sarahemm/stackclock/README.md

# stackclock
StackClock - Modular configurable high-accuracy desk clock
