sarahemm/stackclock/arduino-bsp/README.md

This directory contains the files needed to add board support for the StackClock boards to the Arduino IDE.
