sarahemm/stackclock/display/hardware/stackclock_display.brd

## EAGLE design display/hardware/stackclock_display.brd (2018-03-08)

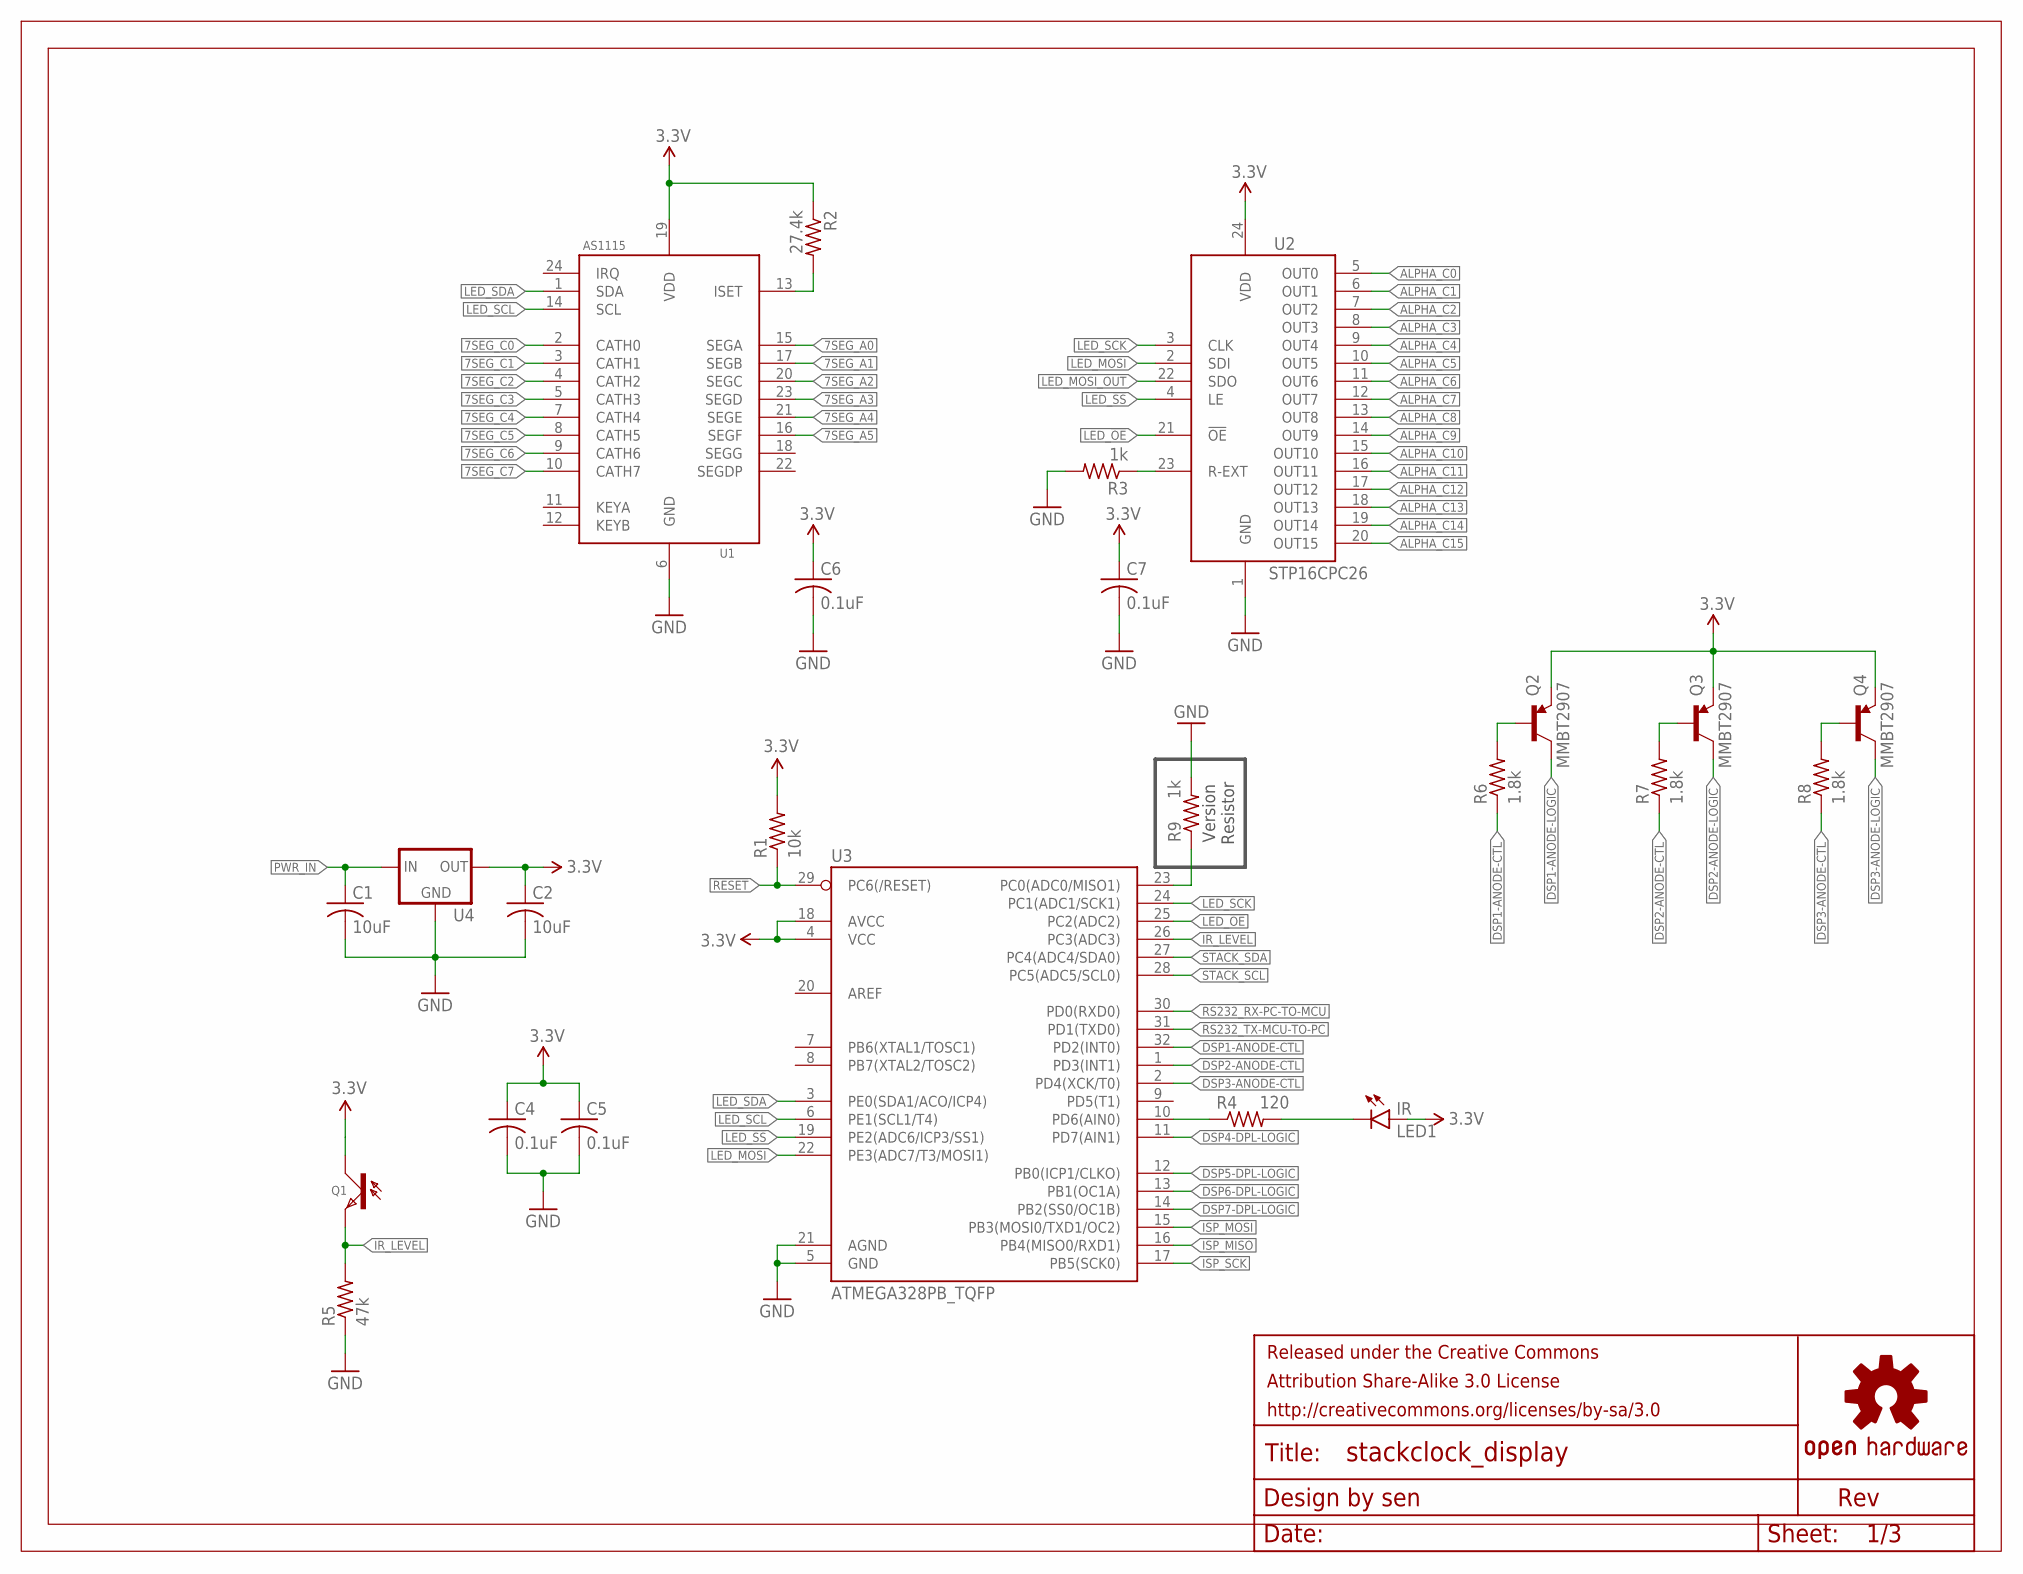
[picture p1: schematic stackclock_display.sch, sheet 1, Logic]

Parts:
C1, C2: 10uF; C0805
C4, C5, C6, C7: 0.1uF; C0603
FRAME1: FRAME-LETTER-GRID-OSHW-SENOSHW-LOGO-L; OSHW-LOGO-L
LED1: IR; LED-1206
Q1: PT15-21C/TR8; 1206_PHOTOTRANSISTOR
Q2, Q3, Q4: MMBT2907; SOT23-3
R1: 10k; R0603
R2: 27.4k; R0603
R3, R9: 1k; R0603
R4: 120; R0603
R5: 47k; R0603
R6, R7, R8: 1.8k; R0603
U1: AS1115; QSOP24
U2: STP16CPC26; TSSOP24
U3: ATMEGA328PB_TQFP; TQFP32-08
U4: NCP1117DT33G; DPAK

Connections:
3.3V: C2.1, C4.1, C5.1, C6.1, C7.1, LED1.A, Q1.C, Q2.2 (E), Q3.2 (E), Q4.2 (E), R1.2, R2.1, U1.19 (VDD), U2.24 (VDD), U3.4 (VCC), U3.18 (AVCC), U4.4 (OUT); also elsewhere on the board
7SEG_A0: U1.15 (SEGA); also elsewhere on the board
7SEG_A1: U1.17 (SEGB); also elsewhere on the board
7SEG_A2: U1.20 (SEGC); also elsewhere on the board
7SEG_A3: U1.23 (SEGD); also elsewhere on the board
7SEG_A4: U1.21 (SEGE); also elsewhere on the board
7SEG_A5: U1.16 (SEGF); also elsewhere on the board
7SEG_C0: U1.2 (CATH0); also elsewhere on the board
7SEG_C1: U1.3 (CATH1); also elsewhere on the board
7SEG_C2: U1.4 (CATH2); also elsewhere on the board
7SEG_C3: U1.5 (CATH3); also elsewhere on the board
7SEG_C4: U1.7 (CATH4); also elsewhere on the board
7SEG_C5: U1.8 (CATH5); also elsewhere on the board
7SEG_C6: U1.9 (CATH6); also elsewhere on the board
7SEG_C7: U1.10 (CATH7); also elsewhere on the board
!RESET: R1.1, U3.29 (PC6(/RESET)); also elsewhere on the board
ALPHA_C0: U2.5 (OUT0); also elsewhere on the board
ALPHA_C1: U2.6 (OUT1); also elsewhere on the board
ALPHA_C2: U2.7 (OUT2); also elsewhere on the board
ALPHA_C3: U2.8 (OUT3); also elsewhere on the board
ALPHA_C4: U2.9 (OUT4); also elsewhere on the board
ALPHA_C5: U2.10 (OUT5); also elsewhere on the board
ALPHA_C6: U2.11 (OUT6); also elsewhere on the board
ALPHA_C7: U2.12 (OUT7); also elsewhere on the board
ALPHA_C8: U2.13 (OUT8); also elsewhere on the board
ALPHA_C9: U2.14 (OUT9); also elsewhere on the board
ALPHA_C10: U2.15 (OUT10); also elsewhere on the board
ALPHA_C11: U2.16 (OUT11); also elsewhere on the board
ALPHA_C12: U2.17 (OUT12); also elsewhere on the board
ALPHA_C13: U2.18 (OUT13); also elsewhere on the board
ALPHA_C14: U2.19 (OUT14); also elsewhere on the board
ALPHA_C15: U2.20 (OUT15); also elsewhere on the board
DSP1-ANODE-CTL: R6.1, U3.32 (PD2(INT0))
DSP1-ANODE-LOGIC: Q2.3 (C); also elsewhere on the board
DSP1-ANODE-QR: Q2.1 (B), R6.2
DSP2-ANODE-CTL: R7.1, U3.1 (PD3(INT1))
DSP2-ANODE-LOGIC: Q3.3 (C); also elsewhere on the board
DSP2-ANODE-QR: Q3.1 (B), R7.2
DSP3-ANODE-CTL: R8.1, U3.2 (PD4(XCK/T0))
DSP3-ANODE-LOGIC: Q4.3 (C); also elsewhere on the board
DSP3-ANODE-QR: Q4.1 (B), R8.2
DSP4-DPL-LOGIC: U3.11 (PD7(AIN1)); also elsewhere on the board
DSP5-DPL-LOGIC: U3.12 (PB0(ICP1/CLKO)); also elsewhere on the board
DSP6-DPL-LOGIC: U3.13 (PB1(OC1A)); also elsewhere on the board
DSP7-DPL-LOGIC: U3.14 (PB2(SS0/OC1B)); also elsewhere on the board
GND: C1.2, C2.2, C4.2, C5.2, C6.2, C7.2, R3.2, R5.1, R9.2, U1.6 (GND), U2.1 (GND), U3.5 (GND), U3.21 (AGND), U4.1 (GND); also elsewhere on the board
HW_VERSION: R9.1, U3.23 (PC0(ADC0/MISO1))
IR_CTL: R4.1, U3.10 (PD6(AIN0))
IR_LEVEL: Q1.E, R5.2, U3.26 (PC3(ADC3)); also elsewhere on the board
IR_R: LED1.C, R4.2
ISP_MISO: U3.16 (PB4(MISO0/RXD1)); also elsewhere on the board
ISP_MOSI: U3.15 (PB3(MOSI0/TXD1/OC2)); also elsewhere on the board
ISP_SCK: U3.17 (PB5(SCK0)); also elsewhere on the board
LED_!OE: U2.21 (!OE), U3.25 (PC2(ADC2)); also elsewhere on the board
LED_!SS: U2.4 (LE), U3.19 (PE2(ADC6/ICP3/SS1)); also elsewhere on the board
LED_MOSI: U2.2 (SDI), U3.22 (PE3(ADC7/T3/MOSI1)); also elsewhere on the board
LED_MOSI_OUT: U2.22 (SDO); also elsewhere on the board
LED_SCK: U2.3 (CLK), U3.24 (PC1(ADC1/SCK1)); also elsewhere on the board
LED_SCL: U1.14 (SCL), U3.6 (PE1(SCL1/T4)); also elsewhere on the board
LED_SDA: U1.1 (SDA), U3.3 (PE0(SDA1/ACO/ICP4)); also elsewhere on the board
PWR_IN: C1.1, U4.3 (IN); also elsewhere on the board
RS232_RX-PC-TO-MCU: U3.30 (PD0(RXD0)); also elsewhere on the board
RS232_TX-MCU-TO-PC: U3.31 (PD1(TXD0)); also elsewhere on the board
STACK_SCL: U3.28 (PC5(ADC5/SCL0)); also elsewhere on the board
STACK_SDA: U3.27 (PC4(ADC4/SDA0)); also elsewhere on the board
U1-ISET: R2.2, U1.13 (ISET)
U2-REXT: R3.1, U2.23 (R-EXT)

Notes on the sheet:
Version Resistor

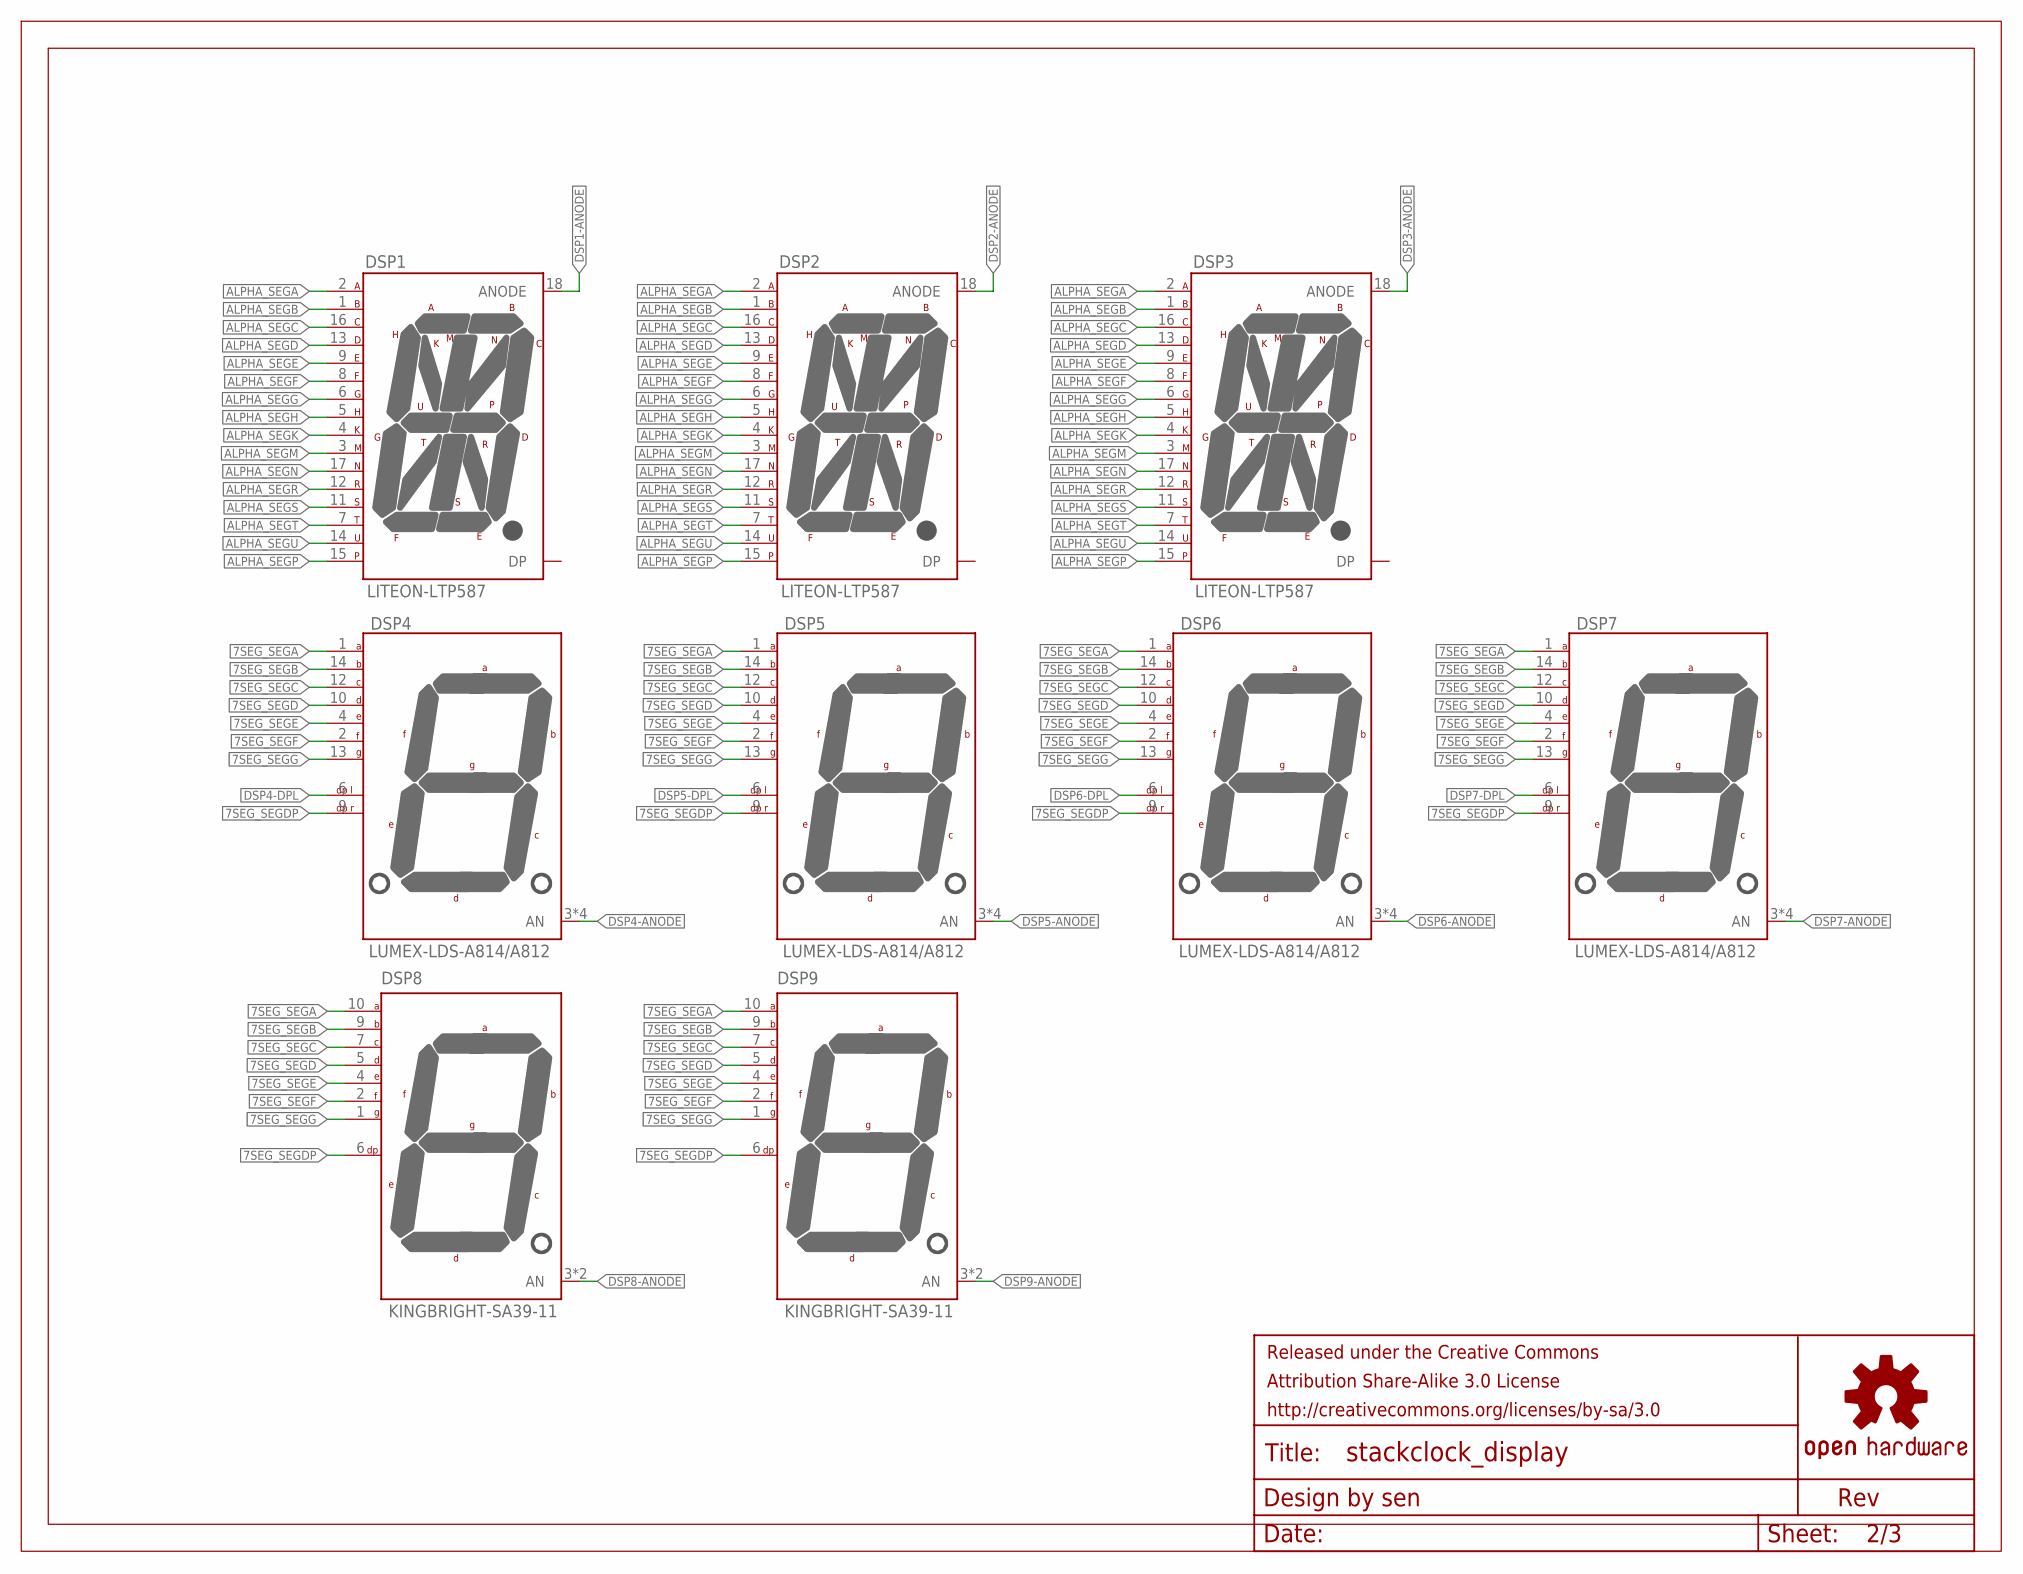
[picture p2: schematic stackclock_display.sch, sheet 2, Display]

Parts:
DSP1, DSP2, DSP3: LITEON-LTP587
DSP4, DSP5, DSP6, DSP7: LUMEX-LDS-A814/A812
DSP8, DSP9: KINGBRIGHT-SA39-11
FRAME2: FRAME-LETTER-GRID-OSHW-SENOSHW-LOGO-L; OSHW-LOGO-L

Connections:
7SEG_SEGA: DSP4.1 (A), DSP5.1 (A), DSP6.1 (A), DSP7.1 (A), DSP8.10 (A), DSP9.10 (A); also elsewhere on the board
7SEG_SEGB: DSP4.14 (B), DSP5.14 (B), DSP6.14 (B), DSP7.14 (B), DSP8.9 (B), DSP9.9 (B); also elsewhere on the board
7SEG_SEGC: DSP4.12 (C), DSP5.12 (C), DSP6.12 (C), DSP7.12 (C), DSP8.7 (C), DSP9.7 (C); also elsewhere on the board
7SEG_SEGD: DSP4.10 (D), DSP5.10 (D), DSP6.10 (D), DSP7.10 (D), DSP8.5 (D), DSP9.5 (D); also elsewhere on the board
7SEG_SEGDP: DSP4.9 (DP-R), DSP5.9 (DP-R), DSP6.9 (DP-R), DSP7.9 (DP-R), DSP8.6 (DP), DSP9.6 (DP); also elsewhere on the board
7SEG_SEGE: DSP4.4 (E), DSP5.4 (E), DSP6.4 (E), DSP7.4 (E), DSP8.4 (E), DSP9.4 (E); also elsewhere on the board
7SEG_SEGF: DSP4.2 (F), DSP5.2 (F), DSP6.2 (F), DSP7.2 (F), DSP8.2 (F), DSP9.2 (F); also elsewhere on the board
7SEG_SEGG: DSP4.13 (G), DSP5.13 (G), DSP6.13 (G), DSP7.13 (G), DSP8.1 (G), DSP9.1 (G); also elsewhere on the board
ALPHA_SEGA: DSP1.2 (A), DSP2.2 (A), DSP3.2 (A); also elsewhere on the board
ALPHA_SEGB: DSP1.1 (B), DSP2.1 (B), DSP3.1 (B); also elsewhere on the board
ALPHA_SEGC: DSP1.16 (C), DSP2.16 (C), DSP3.16 (C); also elsewhere on the board
ALPHA_SEGD: DSP1.13 (D), DSP2.13 (D), DSP3.13 (D); also elsewhere on the board
ALPHA_SEGE: DSP1.9 (E), DSP2.9 (E), DSP3.9 (E); also elsewhere on the board
ALPHA_SEGF: DSP1.8 (F), DSP2.8 (F), DSP3.8 (F); also elsewhere on the board
ALPHA_SEGG: DSP1.6 (G), DSP2.6 (G), DSP3.6 (G); also elsewhere on the board
ALPHA_SEGH: DSP1.5 (H), DSP2.5 (H), DSP3.5 (H); also elsewhere on the board
ALPHA_SEGK: DSP1.4 (K), DSP2.4 (K), DSP3.4 (K); also elsewhere on the board
ALPHA_SEGM: DSP1.3 (M), DSP2.3 (M), DSP3.3 (M); also elsewhere on the board
ALPHA_SEGN: DSP1.17 (N), DSP2.17 (N), DSP3.17 (N); also elsewhere on the board
ALPHA_SEGP: DSP1.15, DSP2.15, DSP3.15; also elsewhere on the board
ALPHA_SEGR: DSP1.12 (R), DSP2.12 (R), DSP3.12 (R); also elsewhere on the board
ALPHA_SEGS: DSP1.11 (S), DSP2.11 (S), DSP3.11 (S); also elsewhere on the board
ALPHA_SEGT: DSP1.7 (T), DSP2.7 (T), DSP3.7 (T); also elsewhere on the board
ALPHA_SEGU: DSP1.14 (U), DSP2.14 (U), DSP3.14 (U); also elsewhere on the board
DSP1-ANODE: DSP1.18 (ANODE); also elsewhere on the board
DSP2-ANODE: DSP2.18 (ANODE); also elsewhere on the board
DSP3-ANODE: DSP3.18 (ANODE); also elsewhere on the board
DSP4-ANODE: DSP4.3 (AN), DSP4.5 (AN), DSP4.11 (AN), DSP4.16 (AN); also elsewhere on the board
DSP4-DPL: DSP4.6 (DP-L); also elsewhere on the board
DSP5-ANODE: DSP5.3 (AN), DSP5.5 (AN), DSP5.11 (AN), DSP5.16 (AN); also elsewhere on the board
DSP5-DPL: DSP5.6 (DP-L); also elsewhere on the board
DSP6-ANODE: DSP6.3 (AN), DSP6.5 (AN), DSP6.11 (AN), DSP6.16 (AN); also elsewhere on the board
DSP6-DPL: DSP6.6 (DP-L); also elsewhere on the board
DSP7-ANODE: DSP7.3 (AN), DSP7.5 (AN), DSP7.11 (AN), DSP7.16 (AN); also elsewhere on the board
DSP7-DPL: DSP7.6 (DP-L); also elsewhere on the board
DSP8-ANODE: DSP8.3 (AN), DSP8.8 (AN); also elsewhere on the board
DSP9-ANODE: DSP9.3 (AN), DSP9.8 (AN); also elsewhere on the board

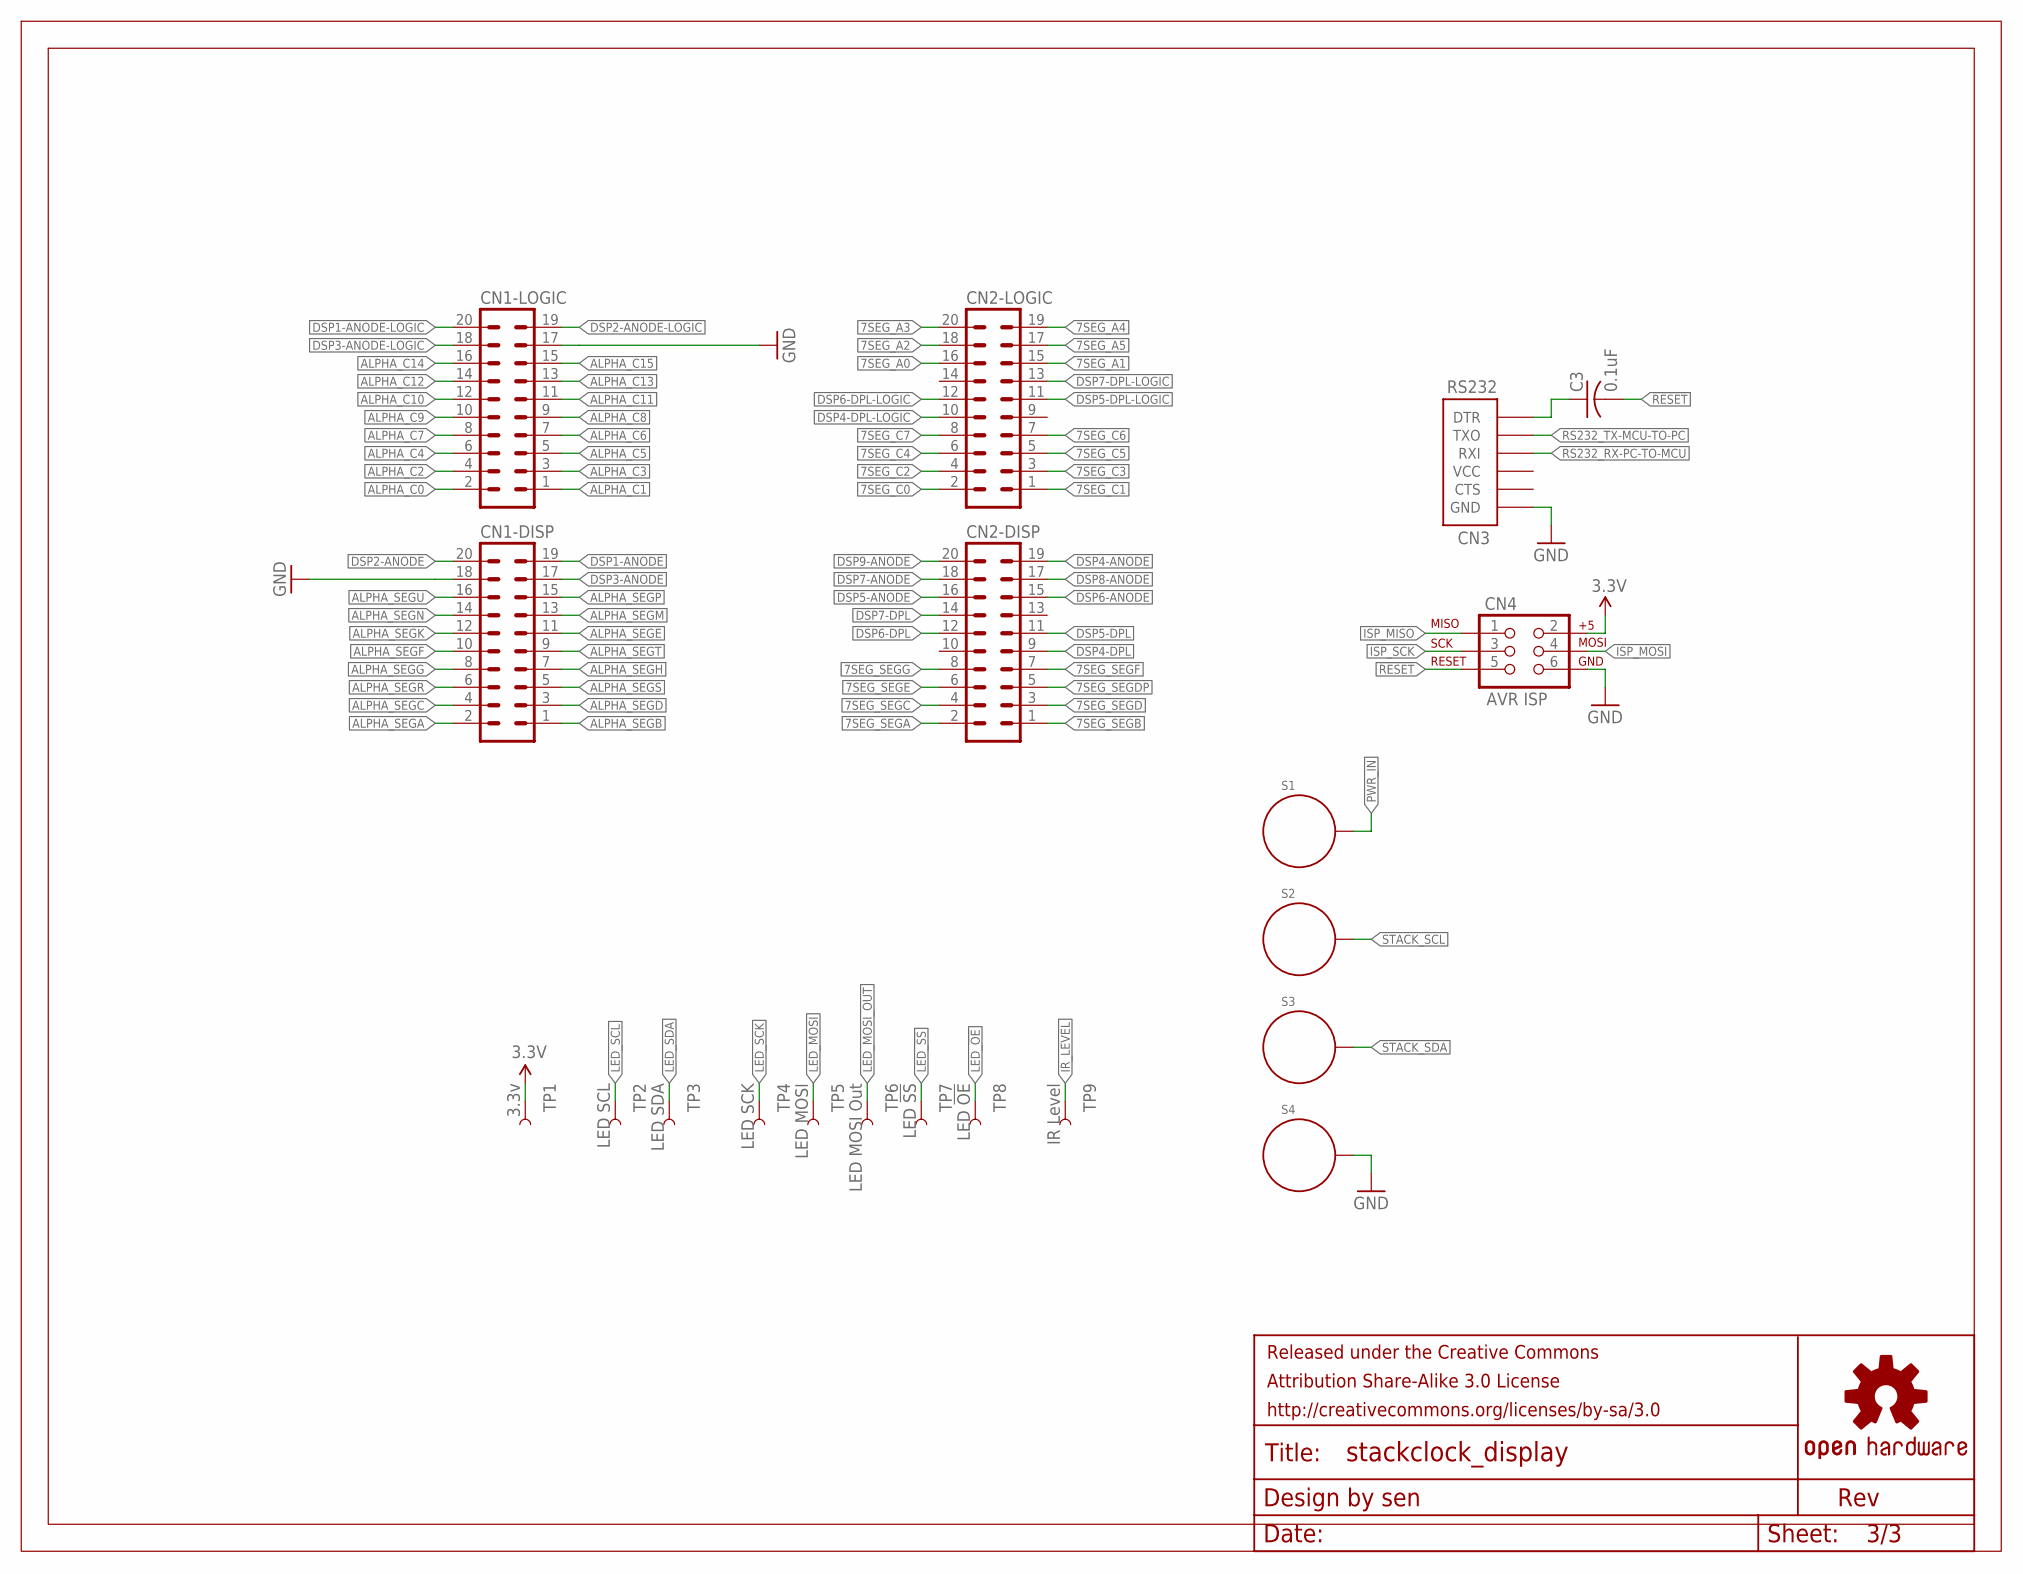
[picture p3: schematic stackclock_display.sch, sheet 3, I/O]

Parts:
C3: 0.1uF; C0603
CN1-DISP, CN2-DISP: MA10-2W
CN1-LOGIC, CN2-LOGIC: MA10-2
CN3: RS232; FTDI_DEVICE_SIDE
CN4: AVR ISP; 2X3_LOCK
FRAME3: FRAME-LETTER-GRID-OSHW-SENOSHW-LOGO-L; OSHW-LOGO-L
S1: +V; STANDOFF-ELECTRICAL
S2: SCL; STANDOFF-ELECTRICAL
S3: SDA; STANDOFF-ELECTRICAL
S4: GND; STANDOFF-ELECTRICAL
TP1: 3.3v; TP_15TH
TP2: LED SCL; TP_15TH
TP3: LED SDA; TP_15TH
TP4: LED SCK; TP_15TH
TP5: LED MOSI; TP_15TH
TP6: LED MOSI Out; TP_15TH
TP7: LED !SS; TP_15TH
TP8: LED !OE; TP_15TH
TP9: IR Level; TP_15TH

Connections:
3.3V: CN4.2, TP1.P$1; also elsewhere on the board
7SEG_A0: CN2-LOGIC.16; also elsewhere on the board
7SEG_A1: CN2-LOGIC.15; also elsewhere on the board
7SEG_A2: CN2-LOGIC.18; also elsewhere on the board
7SEG_A3: CN2-LOGIC.20; also elsewhere on the board
7SEG_A4: CN2-LOGIC.19; also elsewhere on the board
7SEG_A5: CN2-LOGIC.17; also elsewhere on the board
7SEG_C0: CN2-LOGIC.2; also elsewhere on the board
7SEG_C1: CN2-LOGIC.1; also elsewhere on the board
7SEG_C2: CN2-LOGIC.4; also elsewhere on the board
7SEG_C3: CN2-LOGIC.3; also elsewhere on the board
7SEG_C4: CN2-LOGIC.6; also elsewhere on the board
7SEG_C5: CN2-LOGIC.5; also elsewhere on the board
7SEG_C6: CN2-LOGIC.7; also elsewhere on the board
7SEG_C7: CN2-LOGIC.8; also elsewhere on the board
7SEG_SEGA: CN2-DISP.2; also elsewhere on the board
7SEG_SEGB: CN2-DISP.1; also elsewhere on the board
7SEG_SEGC: CN2-DISP.4; also elsewhere on the board
7SEG_SEGD: CN2-DISP.3; also elsewhere on the board
7SEG_SEGDP: CN2-DISP.5; also elsewhere on the board
7SEG_SEGE: CN2-DISP.6; also elsewhere on the board
7SEG_SEGF: CN2-DISP.7; also elsewhere on the board
7SEG_SEGG: CN2-DISP.8; also elsewhere on the board
!RESET: C3.2, CN4.5; also elsewhere on the board
ALPHA_C0: CN1-LOGIC.2; also elsewhere on the board
ALPHA_C1: CN1-LOGIC.1; also elsewhere on the board
ALPHA_C2: CN1-LOGIC.4; also elsewhere on the board
ALPHA_C3: CN1-LOGIC.3; also elsewhere on the board
ALPHA_C4: CN1-LOGIC.6; also elsewhere on the board
ALPHA_C5: CN1-LOGIC.5; also elsewhere on the board
ALPHA_C6: CN1-LOGIC.7; also elsewhere on the board
ALPHA_C7: CN1-LOGIC.8; also elsewhere on the board
ALPHA_C8: CN1-LOGIC.9; also elsewhere on the board
ALPHA_C9: CN1-LOGIC.10; also elsewhere on the board
ALPHA_C10: CN1-LOGIC.12; also elsewhere on the board
ALPHA_C11: CN1-LOGIC.11; also elsewhere on the board
ALPHA_C12: CN1-LOGIC.14; also elsewhere on the board
ALPHA_C13: CN1-LOGIC.13; also elsewhere on the board
ALPHA_C14: CN1-LOGIC.16; also elsewhere on the board
ALPHA_C15: CN1-LOGIC.15; also elsewhere on the board
ALPHA_SEGA: CN1-DISP.2; also elsewhere on the board
ALPHA_SEGB: CN1-DISP.1; also elsewhere on the board
ALPHA_SEGC: CN1-DISP.4; also elsewhere on the board
ALPHA_SEGD: CN1-DISP.3; also elsewhere on the board
ALPHA_SEGE: CN1-DISP.11; also elsewhere on the board
ALPHA_SEGF: CN1-DISP.10; also elsewhere on the board
ALPHA_SEGG: CN1-DISP.8; also elsewhere on the board
ALPHA_SEGH: CN1-DISP.7; also elsewhere on the board
ALPHA_SEGK: CN1-DISP.12; also elsewhere on the board
ALPHA_SEGM: CN1-DISP.13; also elsewhere on the board
ALPHA_SEGN: CN1-DISP.14; also elsewhere on the board
ALPHA_SEGP: CN1-DISP.15; also elsewhere on the board
ALPHA_SEGR: CN1-DISP.6; also elsewhere on the board
ALPHA_SEGS: CN1-DISP.5; also elsewhere on the board
ALPHA_SEGT: CN1-DISP.9; also elsewhere on the board
ALPHA_SEGU: CN1-DISP.16; also elsewhere on the board
DSP1-ANODE: CN1-DISP.19; also elsewhere on the board
DSP1-ANODE-LOGIC: CN1-LOGIC.20; also elsewhere on the board
DSP2-ANODE: CN1-DISP.20; also elsewhere on the board
DSP2-ANODE-LOGIC: CN1-LOGIC.19; also elsewhere on the board
DSP3-ANODE: CN1-DISP.17; also elsewhere on the board
DSP3-ANODE-LOGIC: CN1-LOGIC.18; also elsewhere on the board
DSP4-ANODE: CN2-DISP.19; also elsewhere on the board
DSP4-DPL: CN2-DISP.9; also elsewhere on the board
DSP4-DPL-LOGIC: CN2-LOGIC.10; also elsewhere on the board
DSP5-ANODE: CN2-DISP.16; also elsewhere on the board
DSP5-DPL: CN2-DISP.11; also elsewhere on the board
DSP5-DPL-LOGIC: CN2-LOGIC.11; also elsewhere on the board
DSP6-ANODE: CN2-DISP.15; also elsewhere on the board
DSP6-DPL: CN2-DISP.12; also elsewhere on the board
DSP6-DPL-LOGIC: CN2-LOGIC.12; also elsewhere on the board
DSP7-ANODE: CN2-DISP.18; also elsewhere on the board
DSP7-DPL: CN2-DISP.14; also elsewhere on the board
DSP7-DPL-LOGIC: CN2-LOGIC.13; also elsewhere on the board
DSP8-ANODE: CN2-DISP.17; also elsewhere on the board
DSP9-ANODE: CN2-DISP.20; also elsewhere on the board
GND: CN1-DISP.18, CN1-LOGIC.17, CN3.P$6 (GND), CN4.6, S4.P1; also elsewhere on the board
IR_LEVEL: TP9.P$1; also elsewhere on the board
ISP_MISO: CN4.1; also elsewhere on the board
ISP_MOSI: CN4.4; also elsewhere on the board
ISP_SCK: CN4.3; also elsewhere on the board
LED_!OE: TP8.P$1; also elsewhere on the board
LED_!SS: TP7.P$1; also elsewhere on the board
LED_MOSI: TP5.P$1; also elsewhere on the board
LED_MOSI_OUT: TP6.P$1; also elsewhere on the board
LED_SCK: TP4.P$1; also elsewhere on the board
LED_SCL: TP2.P$1; also elsewhere on the board
LED_SDA: TP3.P$1; also elsewhere on the board
PWR_IN: S1.P1; also elsewhere on the board
RS232_DTR: C3.1, CN3.P$1 (DTR)
RS232_RX-PC-TO-MCU: CN3.P$3 (RXI); also elsewhere on the board
RS232_TX-MCU-TO-PC: CN3.P$2 (TXO); also elsewhere on the board
STACK_SCL: S2.P1; also elsewhere on the board
STACK_SDA: S3.P1; also elsewhere on the board

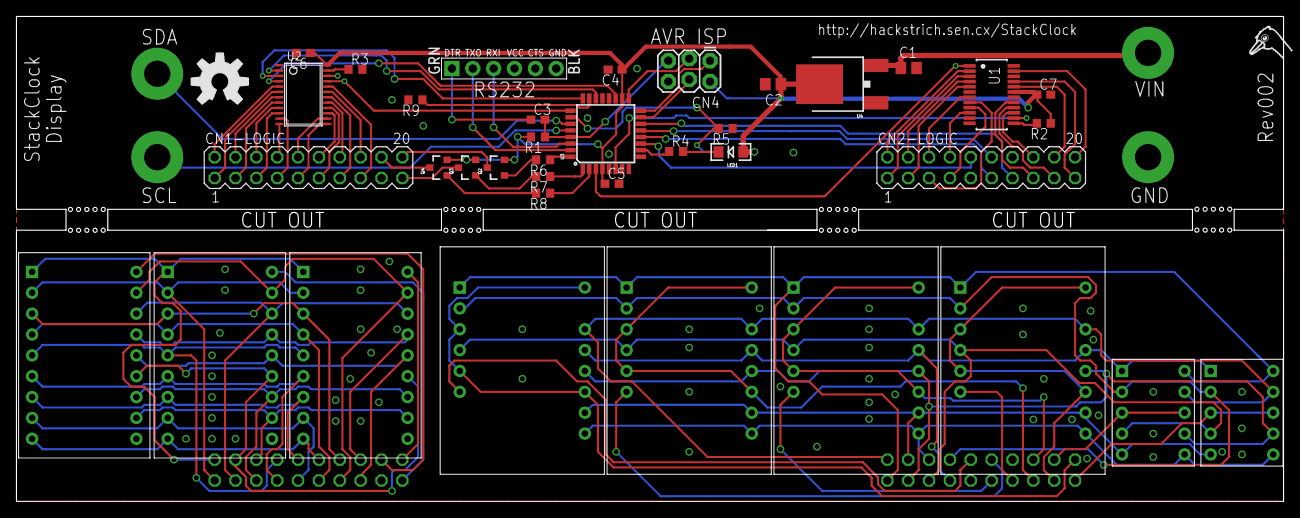
[picture p4: board stackclock_display.brd from above]

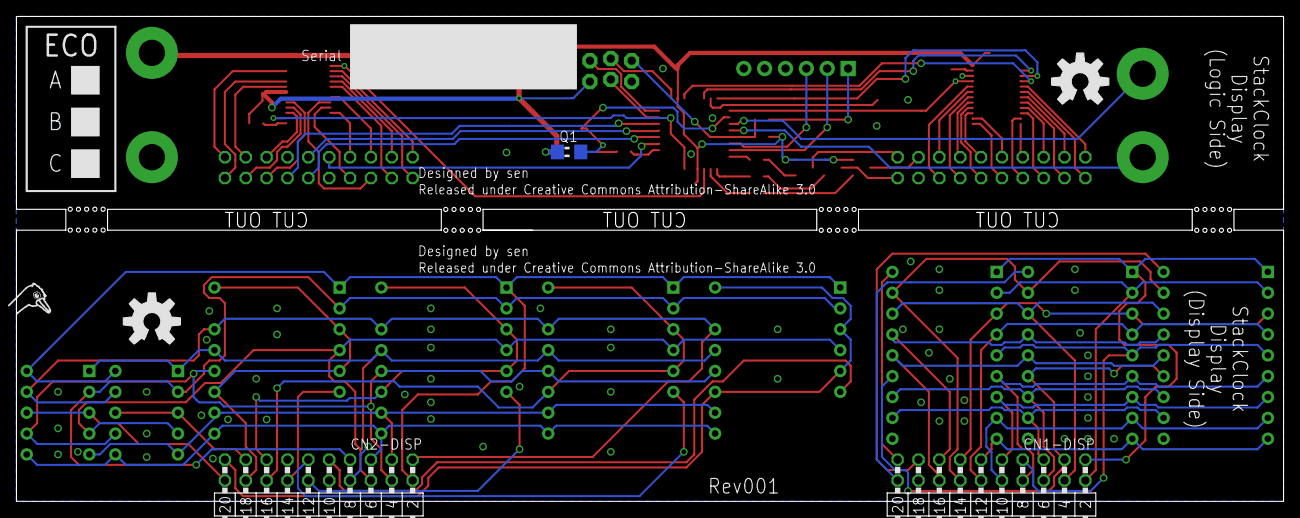
[picture p5: board stackclock_display.brd from below]

Board: 2 copper layers, 154.3 x 59.0 mm, 58 parts (15 on the bottom side), 105 nets.

Other parts of the board:
U$1: STRICH-LOGO-R
U$2: STRICH-LOGO
