sarahemm/stackclock/base/hardware/stackclock_base.brd

## EAGLE design base/hardware/stackclock_base.brd (2017-11-21)

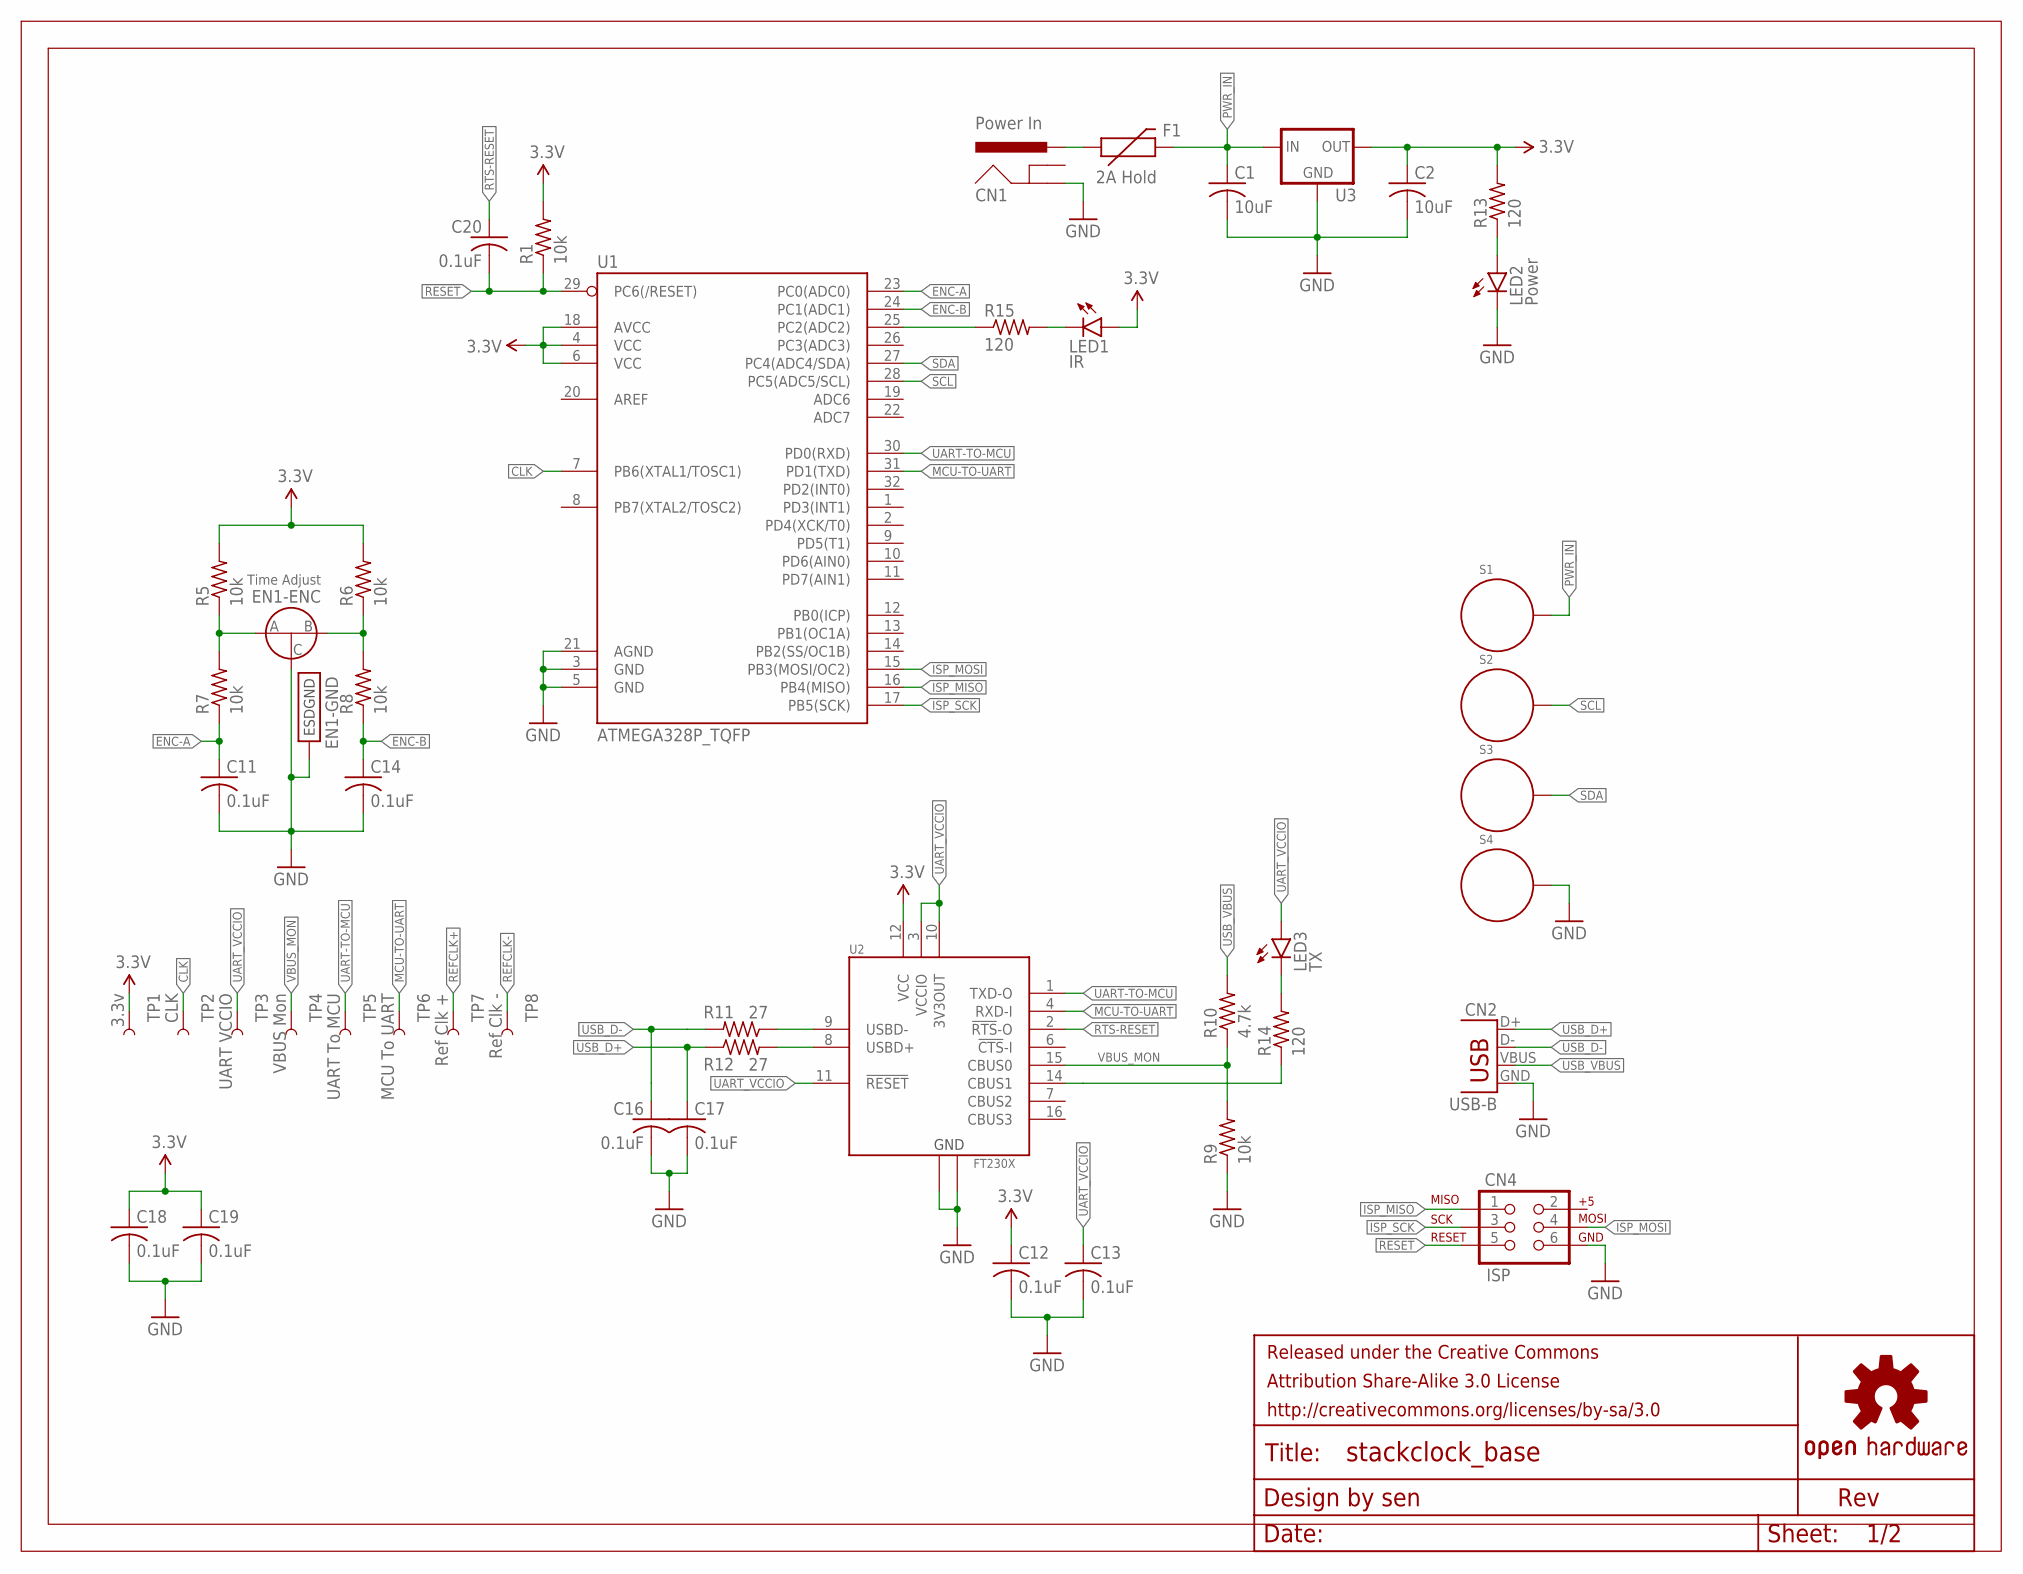
[picture p6: schematic stackclock_base.sch, sheet 1, Logic & I/O]

Parts:
C1, C2: 10uF; C0805
C11, C12, C13, C14, C16, C17, C18, C19, C20: 0.1uF; C0603
CN1: Power In; POWER_JACK_PTH
CN2: USB-B; USB-B-PTH
CN4: ISP; 2X3_LOCK
EN1: Time Adjust; BOURNS-PEC12R-2XXXF-N
F1: 2A Hold; PTC-1206
FRAME1: FRAME-LETTER-GRID-OSHW-SENOSHW-LOGO-L; OSHW-LOGO-L
LED1: IR; LED-1206
LED2: Power; LED-0603
LED3: TX; LED-0603
R1, R5, R6, R7, R8, R9: 10k; R0603
R10: 4.7k; R0603
R11, R12: 27; R0603
R13, R14, R15: 120; R0603
S1: VIN; STANDOFF-ELECTRICAL
S2: SCL; STANDOFF-ELECTRICAL
S3: SDA; STANDOFF-ELECTRICAL
S4: GND; STANDOFF-ELECTRICAL
TP1: 3.3v; TP_15TH
TP2: CLK; TP_15TH
TP3: UART VCCIO; TP_15TH
TP4: VBUS Mon; TP_15TH
TP5: UART To MCU; TP_15TH
TP6: MCU To UART; TP_15TH
TP7: Ref Clk +; TP_15TH
TP8: Ref Clk -; TP_15TH
U1: ATMEGA328P_TQFP; TQFP32-08
U2: FT230X; SSOP16
U3: NCP1117DT33G; DPAK

Connections:
3.3V: C2.1, C12.1, C18.1, C19.1, LED1.A, R1.2, R5.2, R6.2, R13.2, TP1.P$1, U1.4 (VCC), U1.6 (VCC), U1.18 (AVCC), U2.12 (VCC), U3.4 (OUT); also elsewhere on the board
!RESET: C20.2, CN4.5, R1.1, U1.29 (PC6(/RESET))
CLK: TP2.P$1, U1.7 (PB6(XTAL1/TOSC1)); also elsewhere on the board
DATA_LED: R14.1, U2.14 (CBUS1)
ENC-A: C11.1, R7.1, U1.23 (PC0(ADC0))
ENC-A_RAW: EN1.A, R5.1, R7.2
ENC-B: C14.1, R8.1, U1.24 (PC1(ADC1))
ENC-B_RAW: EN1.B, R6.1, R8.2
GND: C1.2, C2.2, C11.2, C12.2, C13.2, C14.2, C16.2, C17.2, C18.2, C19.2, CN1.GND, CN2.GND, CN4.6, EN1.C, EN1.SUPPORT1 (ESDGND), EN1.SUPPORT2 (ESDGND), LED2.C, R9.1, S4.P1, U1.3 (GND), U1.5 (GND), U1.21 (AGND), U2.5 (GND), U2.13 (GND), U3.1 (GND); also elsewhere on the board
IR_CTL: R15.1, U1.25 (PC2(ADC2))
IR_R: LED1.C, R15.2
ISP_MISO: CN4.1, U1.16 (PB4(MISO))
ISP_MOSI: CN4.4, U1.15 (PB3(MOSI/OC2))
ISP_SCK: CN4.3, U1.17 (PB5(SCK))
LED2_R: LED2.A, R13.1
LED3_R: LED3.C, R14.2
MCU-TO-UART: TP6.P$1, U1.31 (PD1(TXD)), U2.4 (RXD-I)
PWR_IN: C1.1, F1.2, S1.P1, U3.3 (IN)
PWR_IN_PREFUSE: CN1.PWR, F1.1
REFCLK+: TP7.P$1; also elsewhere on the board
REFCLK-: TP8.P$1; also elsewhere on the board
RTS-RESET: C20.1, U2.2 (!RTS!-O)
SCL: S2.P1, U1.28 (PC5(ADC5/SCL))
SDA: S3.P1, U1.27 (PC4(ADC4/SDA))
UART-TO-MCU: TP5.P$1, U1.30 (PD0(RXD)), U2.1 (TXD-O)
UART_VCCIO: C13.1, LED3.A, TP3.P$1, U2.3 (VCCIO), U2.10 (3V3OUT), U2.11 (!RESET)
USB_D+: C17.1, CN2.D+, R12.1
USB_D+_POSTRES: R12.2, U2.8 (USBD+)
USB_D-: C16.1, CN2.D-, R11.2
USB_D-_POSTRES: R11.1, U2.9 (USBD-)
USB_VBUS: CN2.VBUS, R10.2
VBUS_MON: R9.2, R10.1, TP4.P$1, U2.15 (CBUS0)

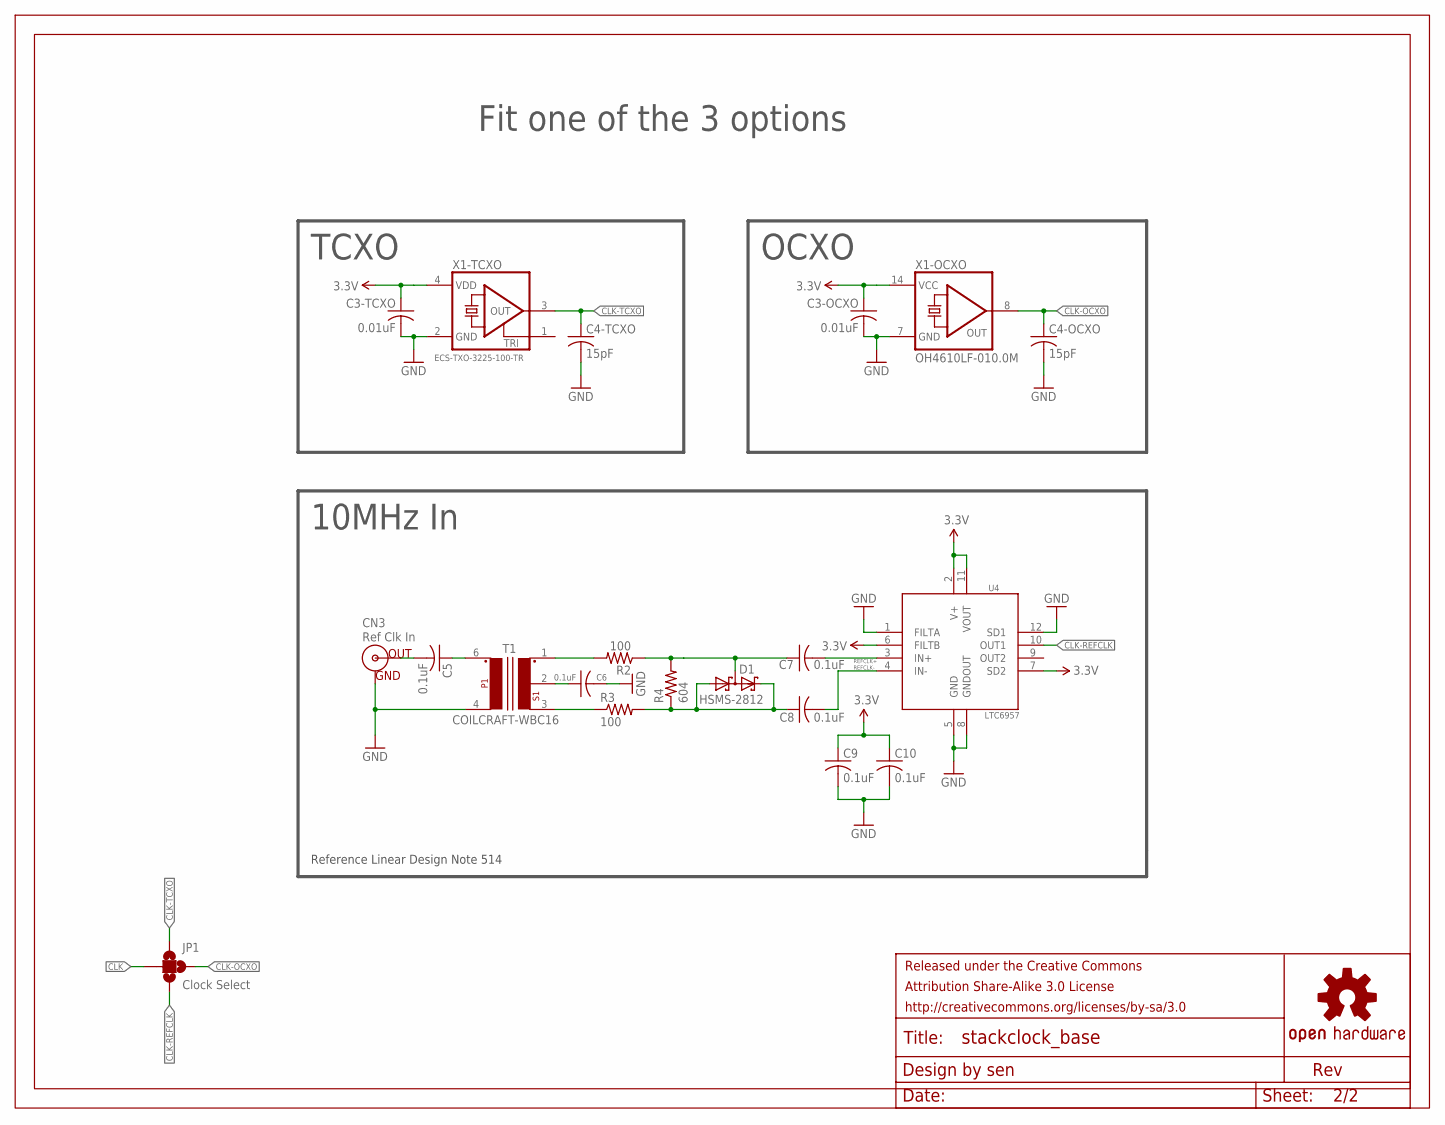
[picture p7: schematic stackclock_base.sch, sheet 2, Oscillators]

Parts:
C3-OCXO, C3-TCXO: 0.01uF; C0603
C4-OCXO, C4-TCXO: 15pF; C0603
C5, C6, C7, C8, C9, C10: 0.1uF; C0603
CN3: Ref Clk In; BNC
D1: HSMS-2812; SOT23
FRAME2: FRAME-LETTER-GRID-OSHW-SENOSHW-LOGO-L; OSHW-LOGO-L
JP1: Clock Select; PAD-JUMPER-4-NO_YES_SILK
R2, R3: 100; R0603
R4: 604; R0603
T1: COILCRAFT-WBC16; COILCRAFT-WBC
U4: LTC6957; MSOP12
X1-OCXO: OH4610LF-010.0M; DIL14S
X1-TCXO: ECS-TXO-3225-100-TR; ASE

Connections:
3.3V: C3-OCXO.1, C3-TCXO.1, C9.1, C10.1, U4.2 (V+), U4.6 (FILTB), U4.7 (SD2), U4.11 (VOUT), X1-OCXO.14 (VCC), X1-TCXO.4 (VDD); also elsewhere on the board
CLK: JP1.C; also elsewhere on the board
CLK-OCXO: C4-OCXO.1, JP1.3, X1-OCXO.8 (OUT)
CLK-REFCLK: JP1.2, U4.10 (OUT1)
CLK-TCXO: C4-TCXO.1, JP1.1, X1-TCXO.3 (OUT)
GND: C3-OCXO.2, C3-TCXO.2, C4-OCXO.2, C4-TCXO.2, C6.2, C9.2, C10.2, CN3.GND, T1.4 (PRI-2), U4.1 (FILTA), U4.5 (GND), U4.8 (GNDOUT), U4.12 (SD1), X1-OCXO.7 (GND), X1-TCXO.2 (GND); also elsewhere on the board
REFCLK+: C7.2, U4.3 (IN+); also elsewhere on the board
REFCLK+-POSTTRANS: R2.2, T1.1 (SEC-1)
REFCLK+-PRECAP: C7.1, D1.3 (C1A2), R2.1, R4.2
REFCLK-: C8.2, U4.4 (IN-); also elsewhere on the board
REFCLK--POSTTRANS: R3.1, T1.3 (SEC-2)
REFCLK--PRECAP: C8.1, D1.1 (A1), D1.2 (C2), R3.2, R4.1
REFCLK-CTRTAP: C6.1, T1.2 (SEC-CT)
REFCLK_IN: C5.2, CN3.S (OUT)
REFCLK_PRETRANS: C5.1, T1.6 (PRI-1)

Notes on the sheet:
10MHz In
TCXO
OCXO
Fit one of the 3 options
Reference Linear Design Note 514

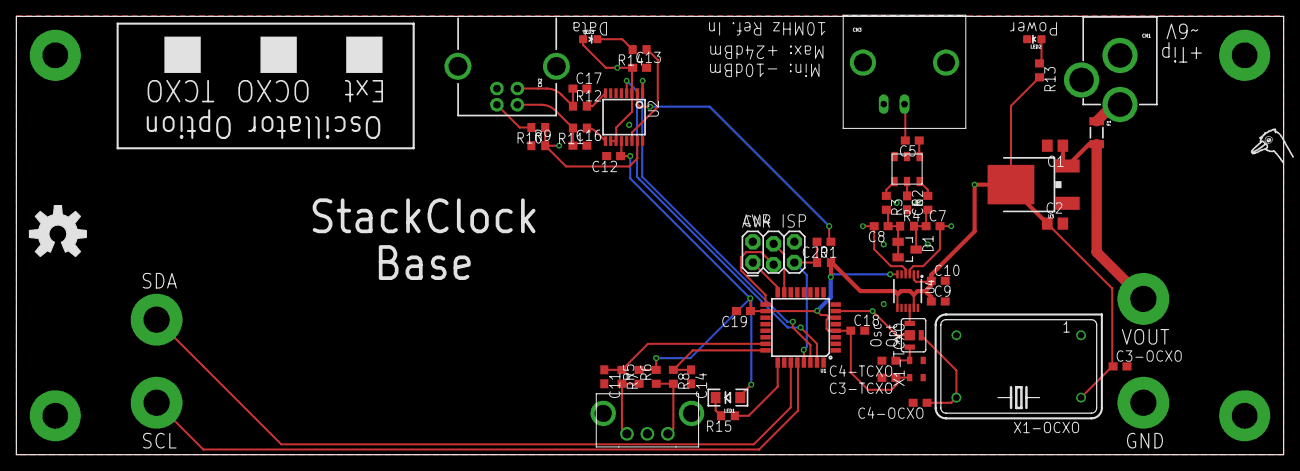
[picture p8: board stackclock_base.brd from above]

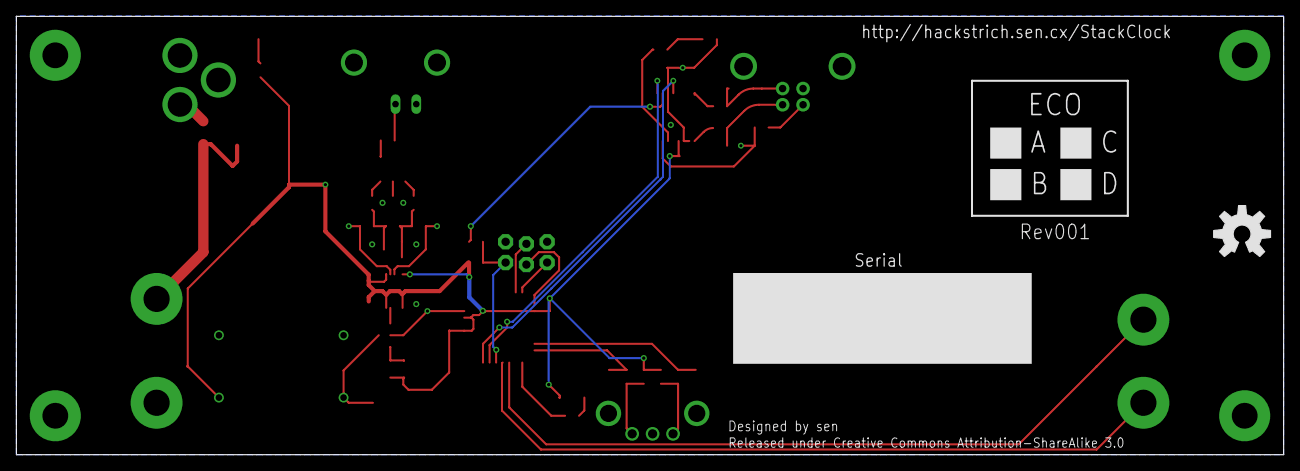
[picture p9: board stackclock_base.brd from below]

Board: 2 copper layers, 154.9 x 53.6 mm, 69 parts (9 on the bottom side), 42 nets.

Other parts of the board:
U$1: STRICH-LOGO
