sarahemm/stackclock/firmware/StackClock-Display/NumericFont.h

// Generated using fonttxt2array.pl
static const unsigned short numeric_font[] = {
  0x5F, 0x06, 0x9B, 0x8F, 0xC6, 0xCD, 0xDD, 0x07, 0xDF, 0xCF,
  0x00, 0x00, 0x00, 0x00, 0x00, 0x00, 0x00, 0x00, 0x00, 0x00,
  0x00, 0x00, 0x00, 0x00, 0x00, 0x00, 0x00, 0x00, 0x00, 0x00,
  0x00, 0x00, 0x00, 0x00, 0x00, 0x00, 0x00, 0x00, 0x00, 0x00,
  0x00, 0x00, 0x00, 0x00, 0x00, 0x00, 0x00, 0x00, 0x00, 0x00
};
