sarahemm/stackclock/firmware/StackClock-Display/AlphaFont.h

// Generated using fonttxt2array.pl
static const unsigned short alpha_font[] = {
  0x0000, 0x0000, 0x0000, 0x0000, 0x0000, 
  0x0000, 0x0000, 0x0000, 0x0000, 0x0000, 
  0x0000, 0x0000, 0x0000, 0x0000, 0x0000, 
  0x0000, 0x0000, 0x0000, 0x0000, 0x0000, 
  0x0000, 0x0000, 0x0000, 0x0000, 0x0000, 
  0x0000, 0x0000, 0x0000, 0x0000, 0x0000, 
  0x0000, 0x0000, 0x0000, 0x0000, 0x0000, 
  0x0000, 0x0000, 0xF969, 0x0000, 0x1000, 
  0x02C1, 0x080E, 0xF530, 0xE020, 0x0010, 
  0xC000, 0x0000, 0x1100, 0x1BCF, 0x000C, 
  0xCA87, 0xCA0F, 0xC04C, 0xCA4B, 0xCACB, 
  0x000F, 0xCACF, 0xCA4F, 0x0000, 0x0000, 
  0x1010, 0xC003, 0x0500, 0x0000, 0x0000, 
  0xC0CF, 0xAA2F, 0x0AC3, 0x2A2F, 0xCAC3, 
  0xC0C3, 0x8ACB, 0xC0CC, 0x2A23, 0x0A8C, 
  0x50D0, 0x0AC0, 0x14CC, 0x04DC, 0x0ACF, 
  0xC0C7, 0x0ADF, 0xC0D7, 0xCA4B, 0x2023, 
  0x0ACC, 0x041C, 0x01DC, 0x1510, 0x1420, 
  0x1B03, 0x02C1, 0x0410, 0x080E, 0x0000, 
  0x0A00, 0x0400, 0xCA8F, 0xCAC8, 0xCA80, 
  0xCA8C, 0xCAC7, 0xE022, 0xC84F, 0xC0C8, 
  0x0021, 0x080C, 0xC0D0, 0x2820, 0xC0A8, 
  0xC088, 0xCA88, 0x50C3, 0x840F, 0x4080, 
  0x8A10, 0xE820, 0x0A88, 0x0018, 0x0198, 
  0x1510, 0xCA4C, 0x4B00, 0x0000, 0x00C0, 
  0x0000, 0x0000, 
};
