sarahemm/stackclock/(commit log)

2017-10-05 Initial work on the schematic for the base.
    Completed main schematic including TCXO, OCXO, and external reference options.
    Still need to do USB interface, IR, and diagnostics (TPs, etc.).
    [stackclock_base.sch]
2017-10-11 Completed and checklisted schematic.
    [stackclock_base.sch]
2017-10-11 Started routing board.
    [stackclock_base.brd, stackclock_base.sch]
2017-10-15 Completed as much routing as possible until Display boards are done.
    [stackclock_base.brd]
2017-10-22 Changed IR LED to SMD so that we can line up bottom/top easier on display boards.
    [stackclock_base.brd, stackclock_base.sch]
2017-10-22 Adding complete/checklisted display schematic.
    [stackclock_display.sch]
2017-10-23 Completed and checklisted board.
    [stackclock_display.brd, stackclock_display.sch]
2017-10-30 Placement mostly complete, routing still in progress.
    [stackclock_base.brd, stackclock_base.sch]
2017-11-01 Tweaked silkscreen slightly.
    [stackclock_base.brd]
2017-11-02 Adding CAM and fixing via tenting on board. Ready for manufacturing.
    [stackclock_display.brd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]
2017-11-02 Increased slot width to meet OSH Park requirments.
    [stackclock_display.brd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]
2017-11-02 Added "CUT OUT" text per OSH Park requirements.
    [stackclock_display.brd]
2017-11-21 Added label to Oscillator Option jumper.
    [stackclock_base.brd]
2017-11-21 Moved TPs to top of board, oops.
    [stackclock_base.brd]
2017-11-21 Completed CAM files.
    [stackclock_base.drills.xln]
2017-12-31 Adding beginning of board support package for Arduino.
2017-12-31 Adding test BSP for the StackClock boards.
    I hate adding ZIP files to Git, but that's what Arduino needs...
2017-12-31 Releasing BSP 1.0.1 which includes the bootloader for the Base board.
    Bootloader is just Optiboot compiled to use 115200bps and a 10Mhz clock.
2018-01-06 Releasing the StackClock BSP 1.0.2 w/ initial support for the Display board.
2018-01-07 Adding bootloader, flashing stuff, and updated pin defs for the Display board.
2018-01-07 Adding libraries for Wire/SPI from wattuino, BSP release 1.0.4.
2018-01-07 Adding current firmware for the Base and Display boards.
2018-02-18 Fixed duplicate definition of PIN_DSP6_DPL and missing PIN_DSP7_DPL.
    [pins_arduino.h]
2018-02-18 Fixing incorrect pins for SCL1 and SDA1. BSP release 1.0.6.
    [pins_arduino.h]
2018-02-19 Fixing bug where address was being sent instead of command.
    [Stack.ino, StackClock-Base.ino]
2018-03-02 Stabilized existing codebase, both Base and Display now work and talk to each other in test mode.
    [DisplayMgr.ino, Stack.ino, StackClock-Base.ino, StackClock-Display.ino]
2018-03-03 Started work on Rev002.
    [stackclock_display.brd, stackclock_display.sch]
2018-03-04 Completed Rev002 Display board, pending checklisting.
    [stackclock_display.brd, stackclock_display.sch]
2018-03-07 Fixed numerous bugs and implemented Time module, now keeps (mostly) time!
    [Stack.ino, StackClock-Base.ino, Time.ino]
2018-03-07 Fixed numerous bugs, still some lurking as the display gets corrupted for one second randomly.
    [Alpha.ino, Numeric.ino, NumericFont.h, Stack.ino]
2018-03-07 Committing final Rev002, ready to go to PCB manufacturing.
    [stackclock_display.brd, stackclock_display.sch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]
2018-03-08 Added version resistor and ECO silkscreen, now final Rev002, submitted for mfg.
    [stackclock_display.brd, stackclock_display.sch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]
2019-01-12 A couple minor optimizations.
2019-01-12 Give the display boards 250ms to initialize before talking to them.
2019-01-12 New BSP release to add timer pin for display board.
2019-01-12 Removed no longer required debug prints.
    [Stack.ino]
2019-01-12 Changed alpha muxing to be timer-based rather than manual.
    Now using TimerOne library and the alphaRefreshDisplays function switches which digit is being displayed each time it is called. Much more stable display now, no matter what else is going on or how busy the I2C bus is.
